RoboAG/eagle_keplerboard/bugfix/bugfix_isp_soldering.jpg

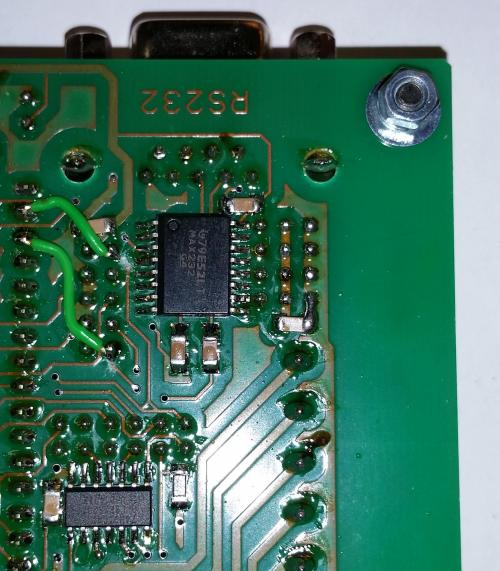
bugfix/bugfix_isp_soldering.jpg
