RoboAG/eagle_keplerboard/bugfix/bugfix_isp_scratching.jpg

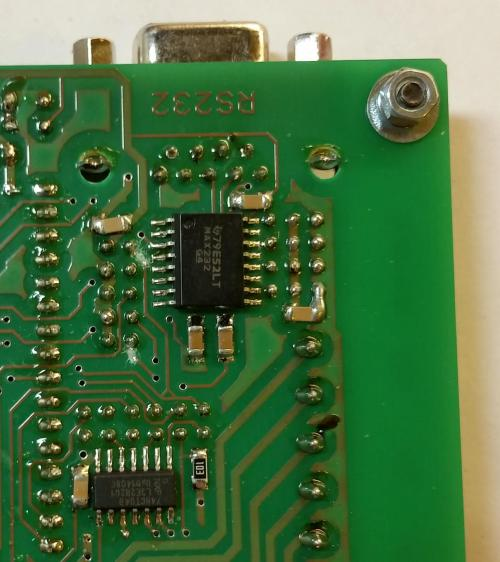
bugfix/bugfix_isp_scratching.jpg
