RoboAG/eagle_keplerboard/README.md

# keplerboard
Circuit for simple robots.
