RoboAG/eagle_keplerboard/bugfix/bugfix_isp_layout.png

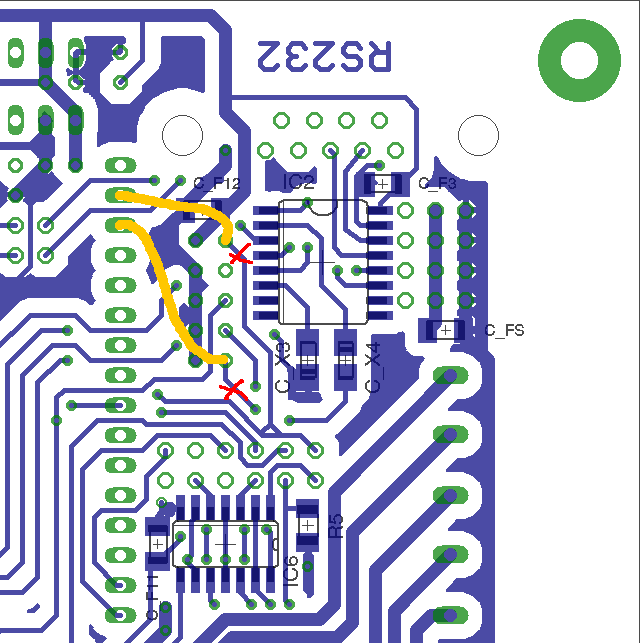
bugfix/bugfix_isp_layout.png
