RoboAG/eagle_keplerboard/bugfix/bugfix_label_porte.png

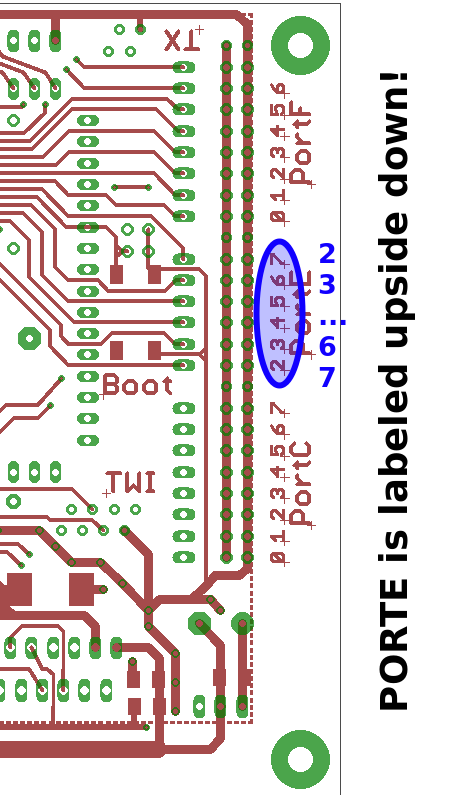
bugfix/bugfix_label_porte.png
