RoboAG/eagle_keplerboard/export/circuit.png

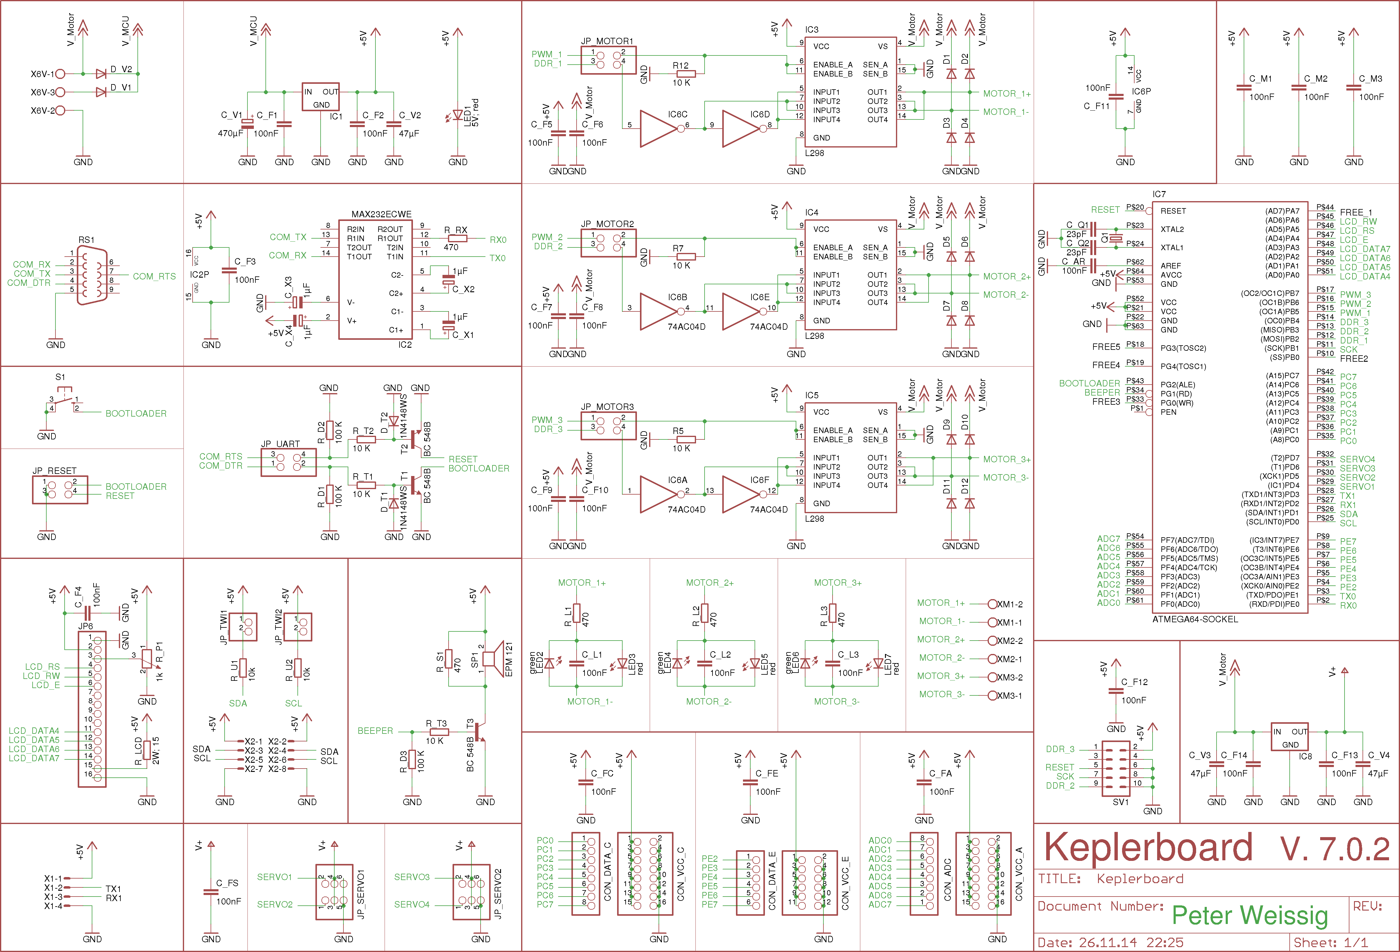
export/circuit.png
