RoboAG/eagle_keplerboard/export/layout_bottom.png

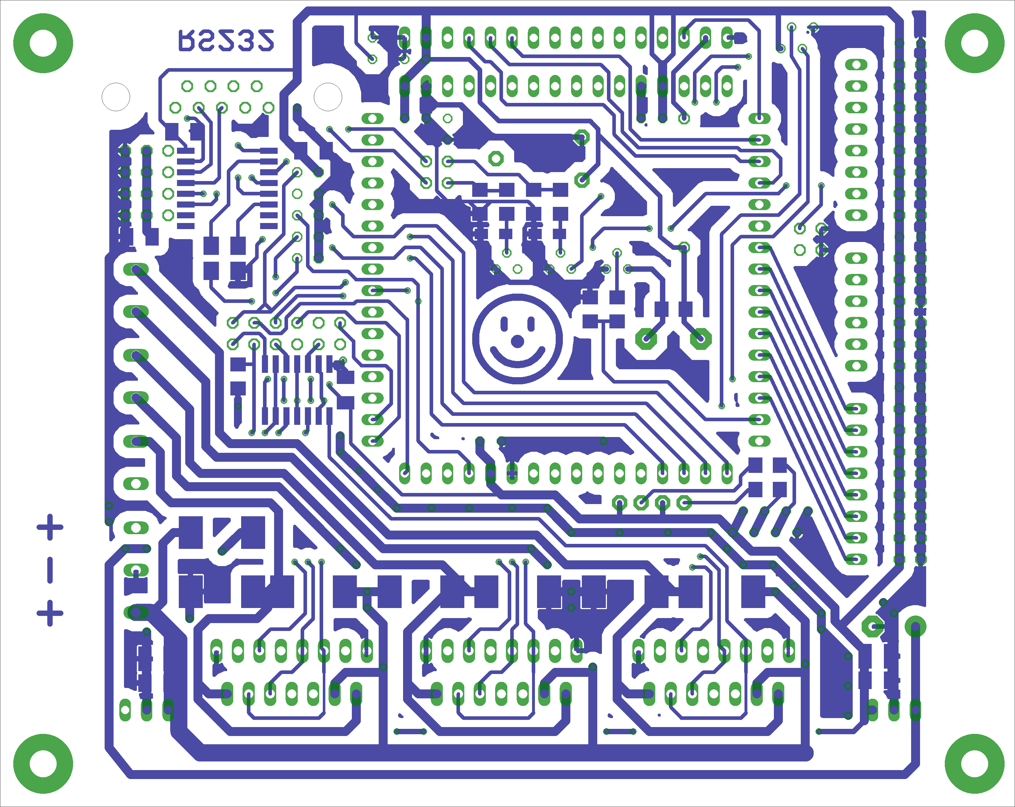
export/layout_bottom.png
