RoboAG/eagle_keplerboard/export/layout_top.png

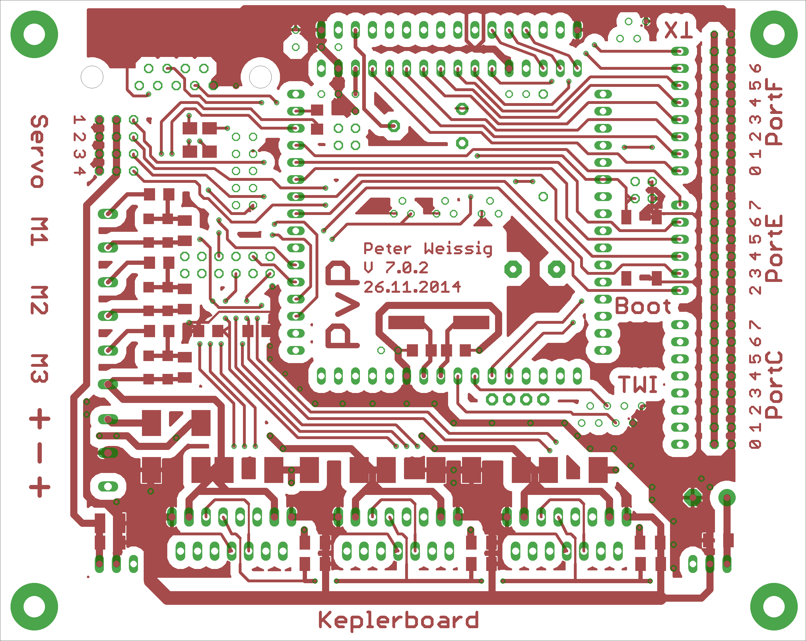
export/layout_top.png
