RoboAG/eagle_keplerboard/parts/parts.ods

Gruppe | Bauelement | Wert | Beschreibung | Bestellung (www.reichelt.de)
Widerstände | R_LCD | 15 | 2W; 12mm; d 4mm | 2W METALL 15 (http://www.reichelt.de/2W-METALL-15/3/index.html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) | 1 | 0,11 € | 0,11 €
 | R_L1 – R_L3 | 470 | SMD 1206; ¼ W | SMD 1/4W 470 (http://www.reichelt.de/SMD-1-4W-470/3/index.html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) | 5 | 0,10 € | 0,52 €
 | R_RX |  |  |  |  |  | 0,00 €
 | R_S1 |  |  |  |  |  | 0,00 €
 | R_P1 | 1k | Poti; liegend; linear | PT 10-L 1,0K (http://www.reichelt.de/PT-10-L-1-0K/3/index.html?ACTION=3&LA=446&ARTICLE=14617&artnr=PT+10-L+1,0K&SEARCH=PT+10-L+1,0K) | 1 | 0,23 € | 0,23 €
 | R5 | 10k | SMD 1206; ¼ W | SMD 1/4W 10K (http://www.reichelt.de/SMD-1-4W-10K/3/index.html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) | 8 | 0,10 € | 0,82 €
 | R7 |  |  |  |  |  | 0,00 €
 | R12 |  |  |  |  |  | 0,00 €
 | R_T1 – RT3 |  |  |  |  |  | 0,00 €
 | R_U1 – RU2 |  |  |  |  |  | 0,00 €
 | R_D1 – R_D3 | 100k | SMD 1206; ¼ W | SMD 1/4W 100K (http://www.reichelt.de/SMD-1-4W-100K/3/index.html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) | 3 | 0,10 € | 0,31 €
Quarz | Q1 | 16 Mhz | SMD; 13x4,7mm | 16,0000-HC49-SMD (http://www.reichelt.de/16-0000-HC49-SMD/3/index.html?ACTION=3&LA=446&ARTICLE=72515&artnr=16,0000-HC49-SMD&SEARCH=16,0000-HC49-SMD) | 1 | 0,19 € | 0,19 €
Kondensatoren | C_Q1 – C_Q2 | 23pF | SMD 1206 | NPO-G1206 22P (http://www.reichelt.de/NPO-G1206-22P/3/index.html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) | 2 | 0,05 € | 0,10 €
 | C_AR | 100nF | 2,54 mm; kerko; 50V | X7R-2,5 100N (http://www.reichelt.de/X7R-2-5-100N/3/index.html?ACTION=3&LA=446&ARTICLE=22853&artnr=X7R-2,5+100N&SEARCH=X7R-2,5+100N) | 8 | 0,04 € | 0,32 €
 | C_FA |  |  |  |  |  | 0,00 €
 | C_FC |  |  |  |  |  | 0,00 €
 | C_FE |  |  |  |  |  | 0,00 €
 | C_M1 – C_M3 |  |  |  |  |  | 0,00 €
 | C_F4 |  |  |  |  |  | 0,00 €
 | C_F1 – C_F3 | 100nF | SMD 1206; kerko; 63V | X7R-G1206 100N (http://www.reichelt.de/Vielschicht-SMD-G1206/X7R-G1206-100N/3/index.html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) | 17 | 0,05 € | 0,85 €
 | C_F5 – C_F14 |  |  |  |  |  | 0,00 €
 | C_FS |  |  |  |  |  | 0,00 €
 | C_L1 – C_L3 |  |  |  |  |  | 0,00 €
 | C_X1 – C_X4 | 1µF | SMD 1206; kerko; 50V | X7R-G1206 1,0/50 (http://www.reichelt.de/Vielschicht-SMD-G1206-High-Cap/X7R-G1206-1-0-50/3/index.html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,0/50) | 4 | 0,04 € | 0,16 €
 | C_V2 – C_V4 | 47µF | SMD 1210; kerko; 16V | X5R-G1210 47 (http://www.reichelt.de/Vielschicht-SMD-G1210-High-Cap/X5R-G1210-47/3/index.html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) | 3 | 0,45 € | 1,35 €
 | C_V1 | 470µF | 5mm; elko; 25V; d 10mm; h 12,5mm | RAD 470/25 (http://www.reichelt.de/Elkos-radial-85-C/RAD-470-25/3/index.html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) | 1 | 0,05 € | 0,05 €
Sum. | SP1 | EPM 121 | 7,6mm; piezo; d 14mm | SUMMER EPM 121 (http://www.reichelt.de/SUMMER-EPM-121/3/index.html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) | 1 | 0,67 € | 0,67 €
Leds | LED1 | red | 3mm; 5V (mit Vorwiderstand) | LED 3MM 5V RT (http://www.reichelt.de/LED-3MM-5V-RT/3/index.html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) | 1 | 0,18 € | 0,18 €
 | LED2 | green | SMD 1206; grün; 2,2V; 25mA | SMD-LED 1206 GN (http://www.reichelt.de/SMD-LED-1206-GN/3/index.html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) | 3 | 0,10 € | 0,30 €
 | LED4 |  |  |  |  |  | 0,00 €
 | LED6 |  |  |  |  |  | 0,00 €
 | LED3 | red | SMD 1206; rot; 2,0V; 30mA | SMD-LED 1206 RT (http://www.reichelt.de/SMD-LED-1206-RT/3/index.html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) | 3 | 0,11 € | 0,33 €
 | LED5 |  |  |  |  |  | 0,00 €
 | LED7 |  |  |  |  |  | 0,00 €
Dioden | D_T1 – D_T2 | 150mA | SMD 1,8x1,4mm; 72V; 0,15A | 1N4148 WS (http://www.reichelt.de/1N-4148-WS/3/index.html?ACTION=3&LA=446&ARTICLE=95197&artnr=1N+4148+WS&SEARCH=1N4148+WS) | 2 | 0,03 € | 0,06 €
 | D1 – D12 | 3A | SMD 6x7mm; Schottky; 60V; 3A | MBRS 360 SMD (http://www.reichelt.de/MBRS-360-SMD/3/index.html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) | 14 | 0,19 € | 2,66 €
 | D_V1 – D_V2 |  |  |  |  |  | 0,00 €
Trans. | T1 – T3 | BC 548B | NPN; 30V; 100mA | BC 548B (http://www.reichelt.de/BC-548B/3/index.html?ACTION=3&LA=446&ARTICLE=5009&artnr=BC+548B&SEARCH=BC+548B) | 3 | 0,04 € | 0,12 €
Schaltkreise | IC1 | 5V | Spg-Reg.; 5V; 1A; Kühlkörper | LM294 CT5 (http://www.reichelt.de/LM-2940-CT5/3/index.html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) | 2 | 0,51 € | 1,02 €
 | IC8 |  |  |  |  |  | 0,00 €
 | IC2 | MAX232 | SMD; Pegelwandler; 5V<->8V | MAX 232 CWE (http://www.reichelt.de/MAX-232-CWE/3/index.html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) | 1 | 0,70 € | 0,70 €
 | IC3 – IC5 | L298 | Motortreiber; 2x2A; 25W | L298 (http://www.reichelt.de/L-298/3/index.html?&ACTION=3&LA=446&ARTICLE=9667&artnr=L+298&SEARCH=L298) | 3 | 2,15 € | 6,45 €
 | IC6 | 74HC04D | SMD; Logikgatter; 6x Inverter | SMD HC 04 (http://www.reichelt.de/SMD-HC-04/3/index.html?ACTION=3&LA=446&ARTICLE=18627&artnr=SMD+HC+04&SEARCH=SMD+HC+04) | 1 | 0,14 € | 0,14 €
 | IC7 | Mega2561 | SMD; RAM 8k; Flash 256k | ATMEGA 2561-16AU (http://www.reichelt.de/ATMEGA-2561-16AU/3/index.html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) | 1 | 8,80 € | 8,80 €
 |  | Stiftl. | 4x 16 pins; 2,54mm; h 8mm | SL 1X36G 2,54 (http://www.reichelt.de/SL-1X36G-2-54/3/index.html?ACTION=3&LA=446&ARTICLE=19504&artnr=SL+1X36G+2,54&SEARCH=SL+1X36G+2,54) | 2 | 0,15 € | 0,30 €
 |  | Kond. | 1µF; SMD 1206; kerko; 50V | X7R-G1206 1,0/50 (http://www.reichelt.de/Vielschicht-SMD-G1206-High-Cap/X7R-G1206-1-0-50/3/index.html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,0/50) | 3 | 0,04 € | 0,12 €
 |  | Platine | Atmega-Adapter-Platine |  | 1 |  | 0,00 €
Taster | S1 | Kurzhub | SMD; h 5mm | TASTER 9315 (http://www.reichelt.de/Kurzhubtaster/TASTER-9315/3/index.html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) | 1 | 0,20 € | 0,20 €
Buchsenleisten | CON_ADC | 1x8 | 8 pins; 2,54mm; h 8mm | BL 1X20G8 2,54 (http://www.reichelt.de/BL-1X20G8-2-54/3/index.html?ACTION=3&LA=446&ARTICLE=51827&artnr=BL+1X20G8+2,54&SEARCH=BL+1X20G8+2,54) | 7 | 0,31 € | 2,17 €
 | CON_DATA_C |  |  |  |  |  | 0,00 €
 | CON_DATA_E | 1x6 | 6 pins; 2,54mm; h 8mm |  |  |  | 0,00 €
 | IC7 – Atmega | 4x 1x16 | 4x 16 pins; 2,54mm; h 8mm |  |  |  | 0,00 €
 | JP16 | 1x16 | 16 pins; 2,54mm; h 8mm |  |  |  | 0,00 €
 | CON_VCC_A | 2x8 | 2x8 pins; 2,54mm; h 8mm | BL 2X10G8 2,54 (http://www.reichelt.de/BL-2X10G8-2-54/3/index.html?ACTION=3&LA=446&ARTICLE=51833&artnr=BL+2X10G8+2,54&SEARCH=BL+2X+10G8+2,54) | 3 | 0,29 € | 0,87 €
 | CON_VCC_C |  |  |  |  |  | 0,00 €
 | CON_VCC_E |  |  |  |  |  | 0,00 €
Stiftleiste | JP_TWI1 | 1x2 | Zusammen: 1x4 pins; 2,54mm; h 8mm | SL 1X36G 2,54 (http://www.reichelt.de/SL-1X36G-2-54/3/index.html?ACTION=3&LA=446&ARTICLE=19504&artnr=SL+1X36G+2,54&SEARCH=SL+1X36G+2,54) | 1 | 0,15 € | 0,15 €
 | JP_TWI2 |  |  |  |  |  | 0,00 €
 | JP_MOTOR1 | 2x2 | Zusammen: 2x6 pins; 2,54mm; h 8mm | SL 2X36G 2,54 (http://www.reichelt.de/SL-2X36G-2-54/3/index.html?ACTION=3&LA=446&ARTICLE=19496&artnr=SL+2X36G+2,54&SEARCH=SL+2X36G+2,54) | 1 | 0,32 € | 0,32 €
 | JP_MOTOR2 |  |  |  |  |  | 0,00 €
 | JP_MOTOR3 |  |  |  |  |  | 0,00 €
 | JP_RESET | 2x2 | 2x2 pins; 2,54mm; h 8mm |  |  |  | 0,00 €
 | JP_SERVO1 | 2x3 | 2x3 pins; 2,54mm; h 8mm |  |  |  | 0,00 €
 | JP_SERVO2 |  |  |  |  |  | 0,00 €
 | JP_UART | 2x2 | 2x2 pins; 2,54mm; h 8mm |  |  |  | 0,00 €
Anschlüße | SV1 | 2x5 | 2x5 pins; Wannenstecker | WSL 10G (http://www.reichelt.de/WSL-10G/3/index.html?ACTION=3&LA=446&ARTICLE=22816&artnr=WSL+10G&SEARCH=WSL+10G) | 1 | 0,08 € | 0,08 €
 | X1 | 2x2 | micromatch 4polig | MM FL 4G (http://www.reichelt.de/Micro-Match-Verbinder/MM-FL-4G/3/index.html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) | 1 | 0,25 € | 0,25 €
 | X2 | 2x4 | micromatch 8polig | MM FL 8G (http://www.reichelt.de/Micro-Match-Verbinder/MM-FL-8G/3/index.html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) | 1 | 0,41 € | 0,41 €
 | X6V | 1x3 | 5,08mm; Schraubanschluss | AKL101-03 (http://www.reichelt.de/index.html?ACTION=3;ARTICLE=36606;SEARCH=AKL%20101-03) | 1 | 0,31 € | 0,31 €
 | XM1 – XM3 | 1x2 | 5,08mm; Schraubanschluss | AKL101-02 (http://www.reichelt.de/RIA-Stecksystem/AKL-101-02/3/index.html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) | 3 | 0,31 € | 0,93 €
 | RS1 | dsub9 | Buchse | D-SUB BU 09EU (http://www.reichelt.de/D-SUB-BU-09EU/3/index.html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) | 1 | 0,39 € | 0,39 €
Extras | Stecker für UART (Xbee) |  | Stecker für micromatch 4polig | MM SL 4SK (http://www.reichelt.de/Micro-Match-Verbinder/MM-SL-4SK/3/index.html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) |  | 0,23 € | 0,00 €
 | Stecker für TWI |  | Stecker für micromatch 8polig | MM SL 8SK (http://www.reichelt.de/Micro-Match-Verbinder/MPE-371-1-008/3/index.html?ACTION=3;ARTICLE=52838;SEARCH=MM%20SL%208SK) |  | 0,28 € | 0,00 €
 | Anschluss von Sensoren und Display |  | 16er-Kabel; grau; 3m | AWG 28-16G 3M (http://www.reichelt.de/Flachbandkabel/AWG-28-16G-3M/3/index.html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) |  | 1,75 € | 0,00 €
 |  |  | 16er-Kabel; bunt; 3m | AWG 28-16F 3M (http://www.reichelt.de/Flachbandkabel/AWG-28-16F-3M/3/index.html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) |  | 3,00 € | 0,00 €
 |  |  | Stiftleisten | SL 1X36G 2,54 (http://www.reichelt.de/SL-1X36G-2-54/3/index.html?ACTION=3&LA=446&ARTICLE=19504&artnr=SL+1X36G+2,54&SEARCH=SL+1X36G+2,54) |  | 0,15 € | 0,00 €
 |  |  | Schrumpfschlauch; Schwarz | SDH 1,6 SW (http://www.reichelt.de/Schrumpfschlauch-Abschnitte/SDH-1-6-SW/3/index.html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,6+SW) |  | 0,25 € | 0,00 €
 |  |  | Schrumpfschlauch; Rot | SDH 1,6 RT (http://www.reichelt.de/Schrumpfschlauch-Abschnitte/SDH-1-6-RT/3/index.html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,6+RT) |  | 0,32 € | 0,00 €
 |  |  | Schrumpfschlauch; Blau | SDH 1,6 BL (http://www.reichelt.de/Schrumpfschlauch-Abschnitte/SDH-1-6-BL/3/index.html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,6+BL) |  | 0,32 € | 0,00 €
 | Versand |  |  |  | 1 | 5,60 € | 5,60 €
 |  |  |  | Summe | 38,54 €
