RoboAG/eagle_keplerboard/export/parts_bottom.png

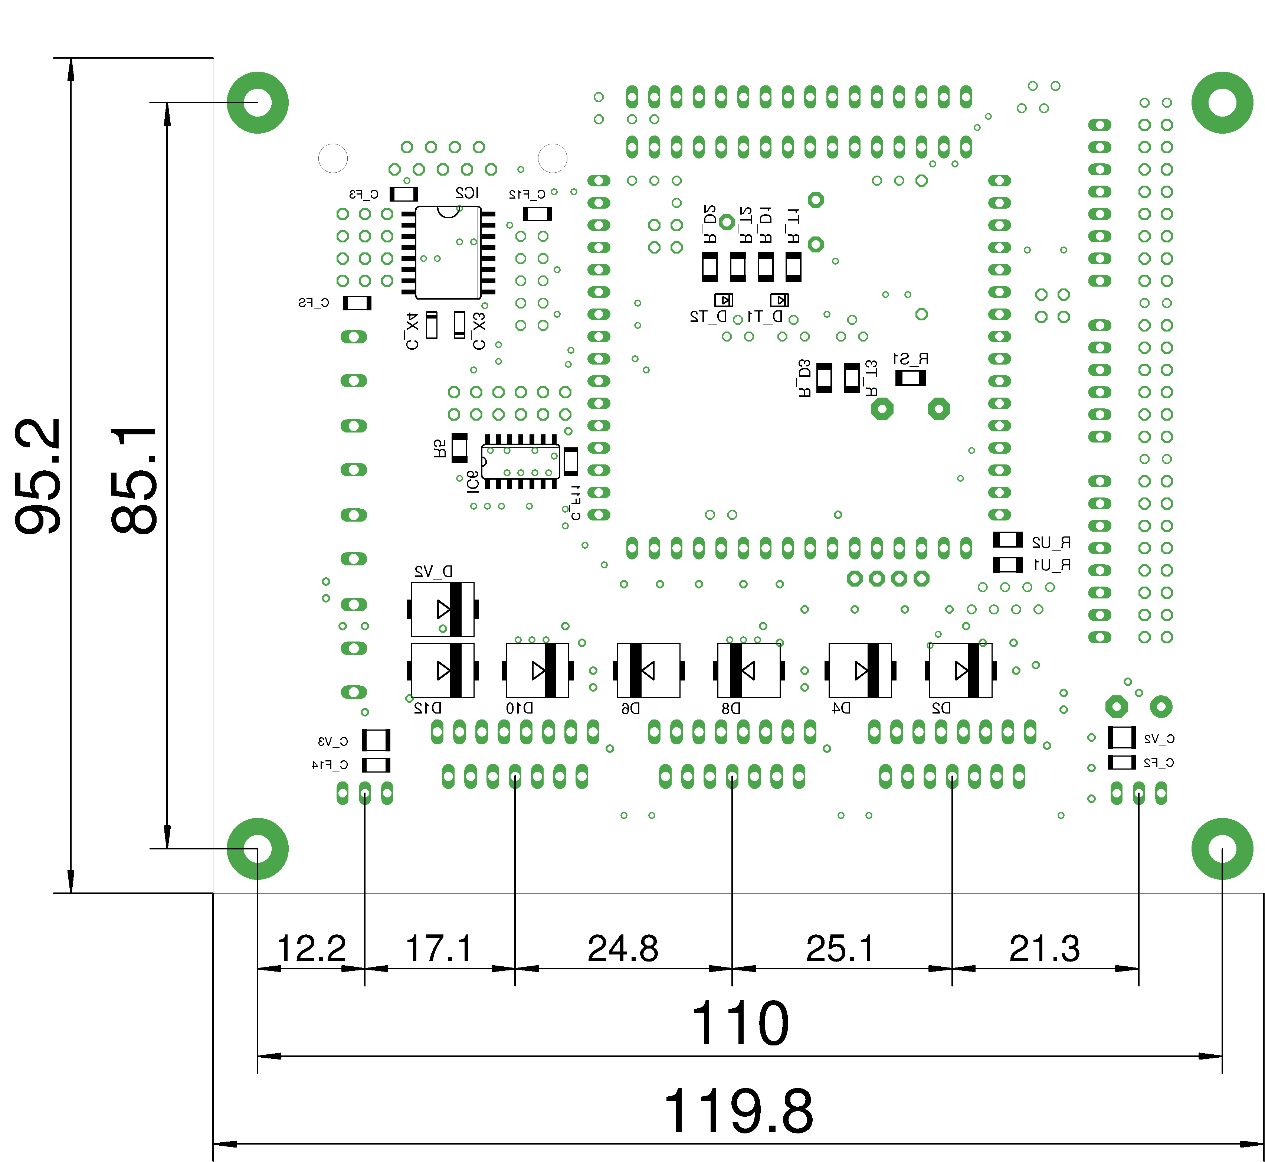
export/parts_bottom.png
