RoboAG/eagle_keplerboard/export/parts_top.png

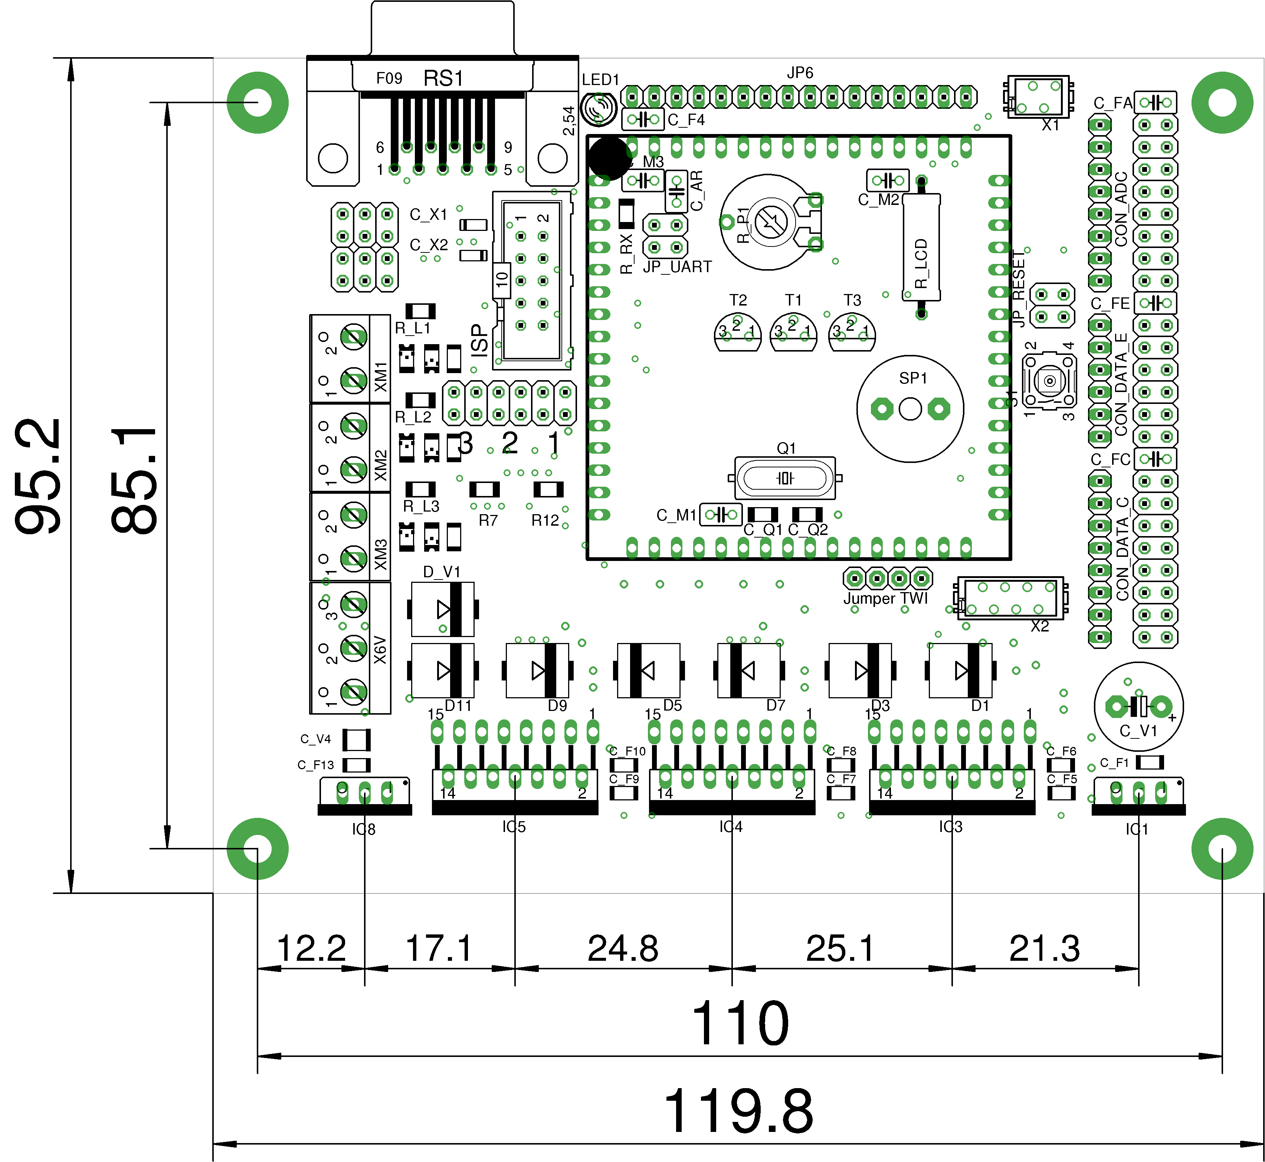
export/parts_top.png
