RoboAG/eagle_keplerboard/parts/parts.pdf

# Bauteile Keplerboard V7.0.2

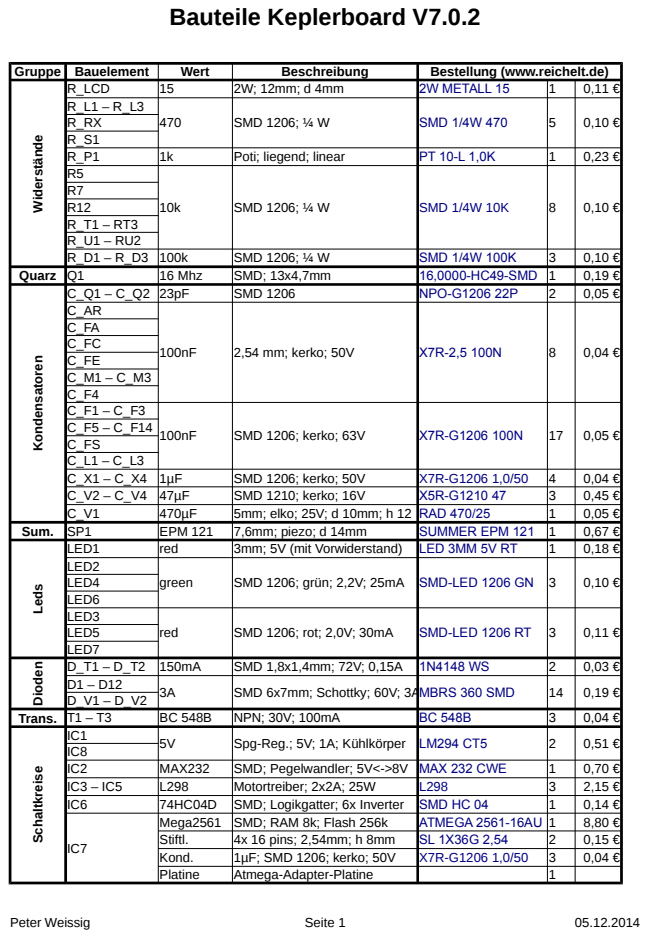
[picture p10: page 1]

# Bauteile Keplerboard V7.0.2

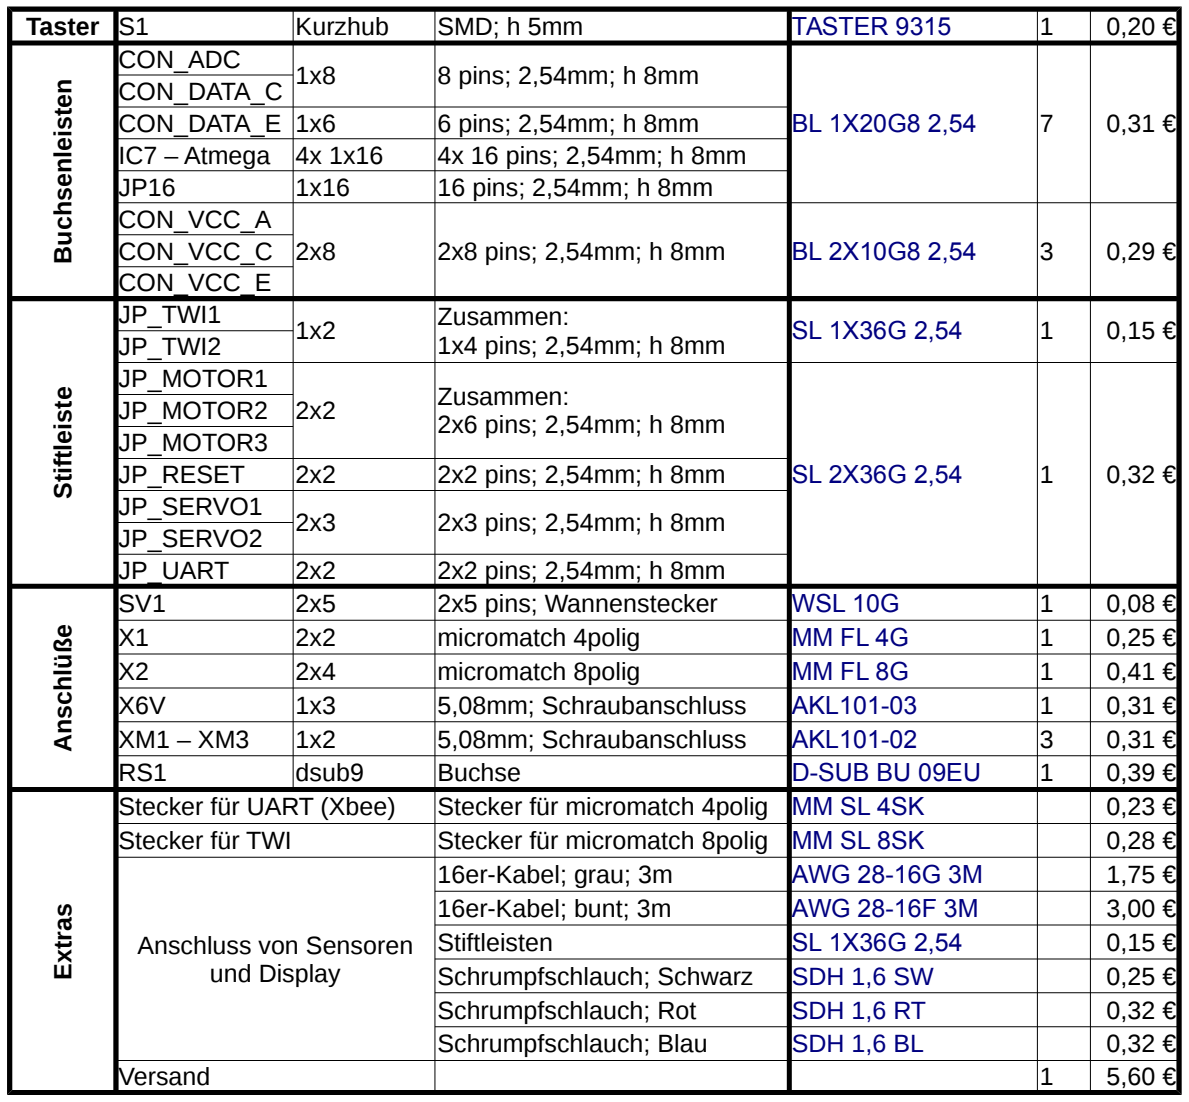
[picture p11: figure]
Taster S1; Kurzhub; SMD; h 5mm; nleiste; CON_ADC; 8 pins; 2,54mm; h 8mm; CON_DATA_C; CON_DATA_E; 6 pins; 2,54mm; h 8mm; 16 pins; 2,54mm; h 8mm; CON_VCC_A; CON_VCC_C; 2x8 pins; 2,54mm; h 8mm; CON_VCC_E; Stiftleiste; JP_TWI1; 0,15 € JP_TWI2; JP_MOTOR1; JP_MOTOR2 JP_MOTOR3; JP_RESET; 2x2 pins; 2,54mm; h 8mm; JP_UART; hlü; 2x5 pins; Wannenstecker; micromatch 4polig; micromatch 8polig; 5,08mm; Schraubanschluss; dsub9; Buchse; xtra; Stecker für UART (Xbee); Stecker für micromatch 4polig; Stecker für TWI; Stecker für micromatch 8polig; 16er-Kabel; grau; 3m; 16er-Kabel; bunt; 3m; Stiftleisten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

Peter Weissig | Seite 2 | 05.12.2014
IC7 – Atmega | 4x 1x16 | 4x 16 pins; 2,54mm; h 8mm
JP_SERVO1 | 2x3 | 2x3 pins; 2,54mm; h 8mm JP_SERVO2
Summe | 38,54 €
