RoboAG/eagle_keplerboard/export/circuit.pdf

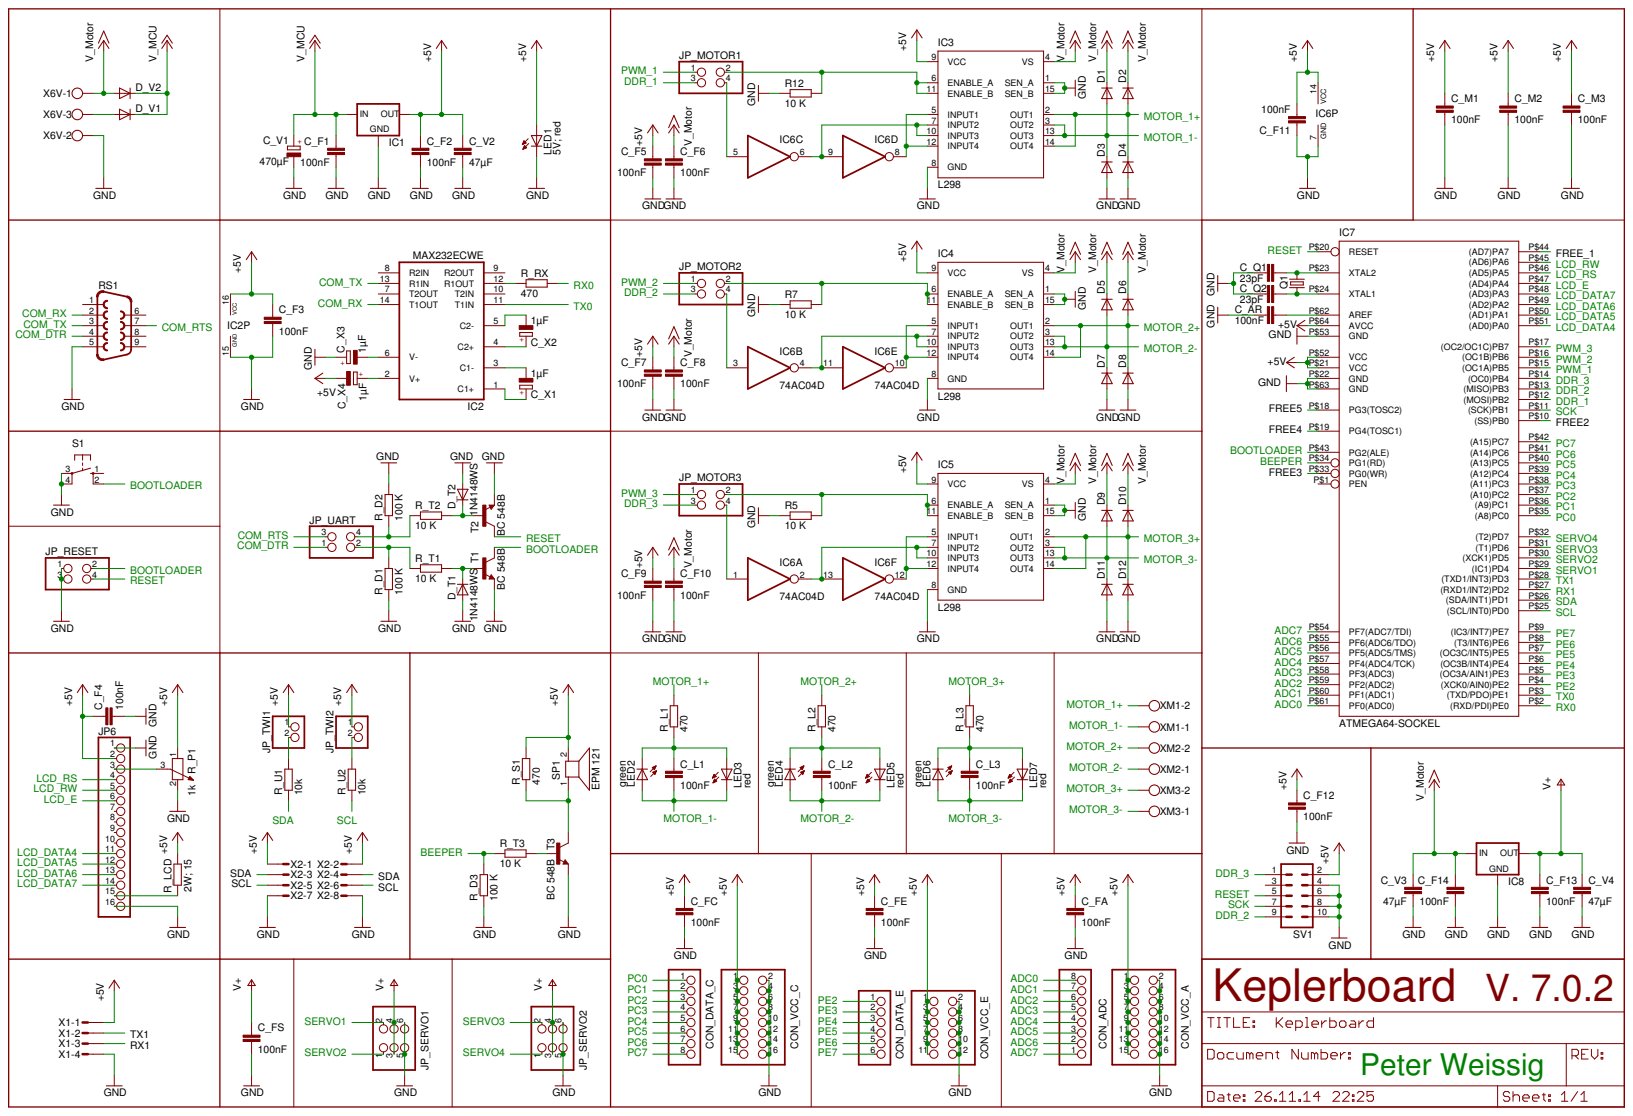
[picture p12: page 1]

V_MCU GND GND GND GND GND

GNDGND
