RoboAG/eagle_keplerboard/circuit/circuit.brd

## EAGLE design circuit/circuit.brd (2015-09-28)

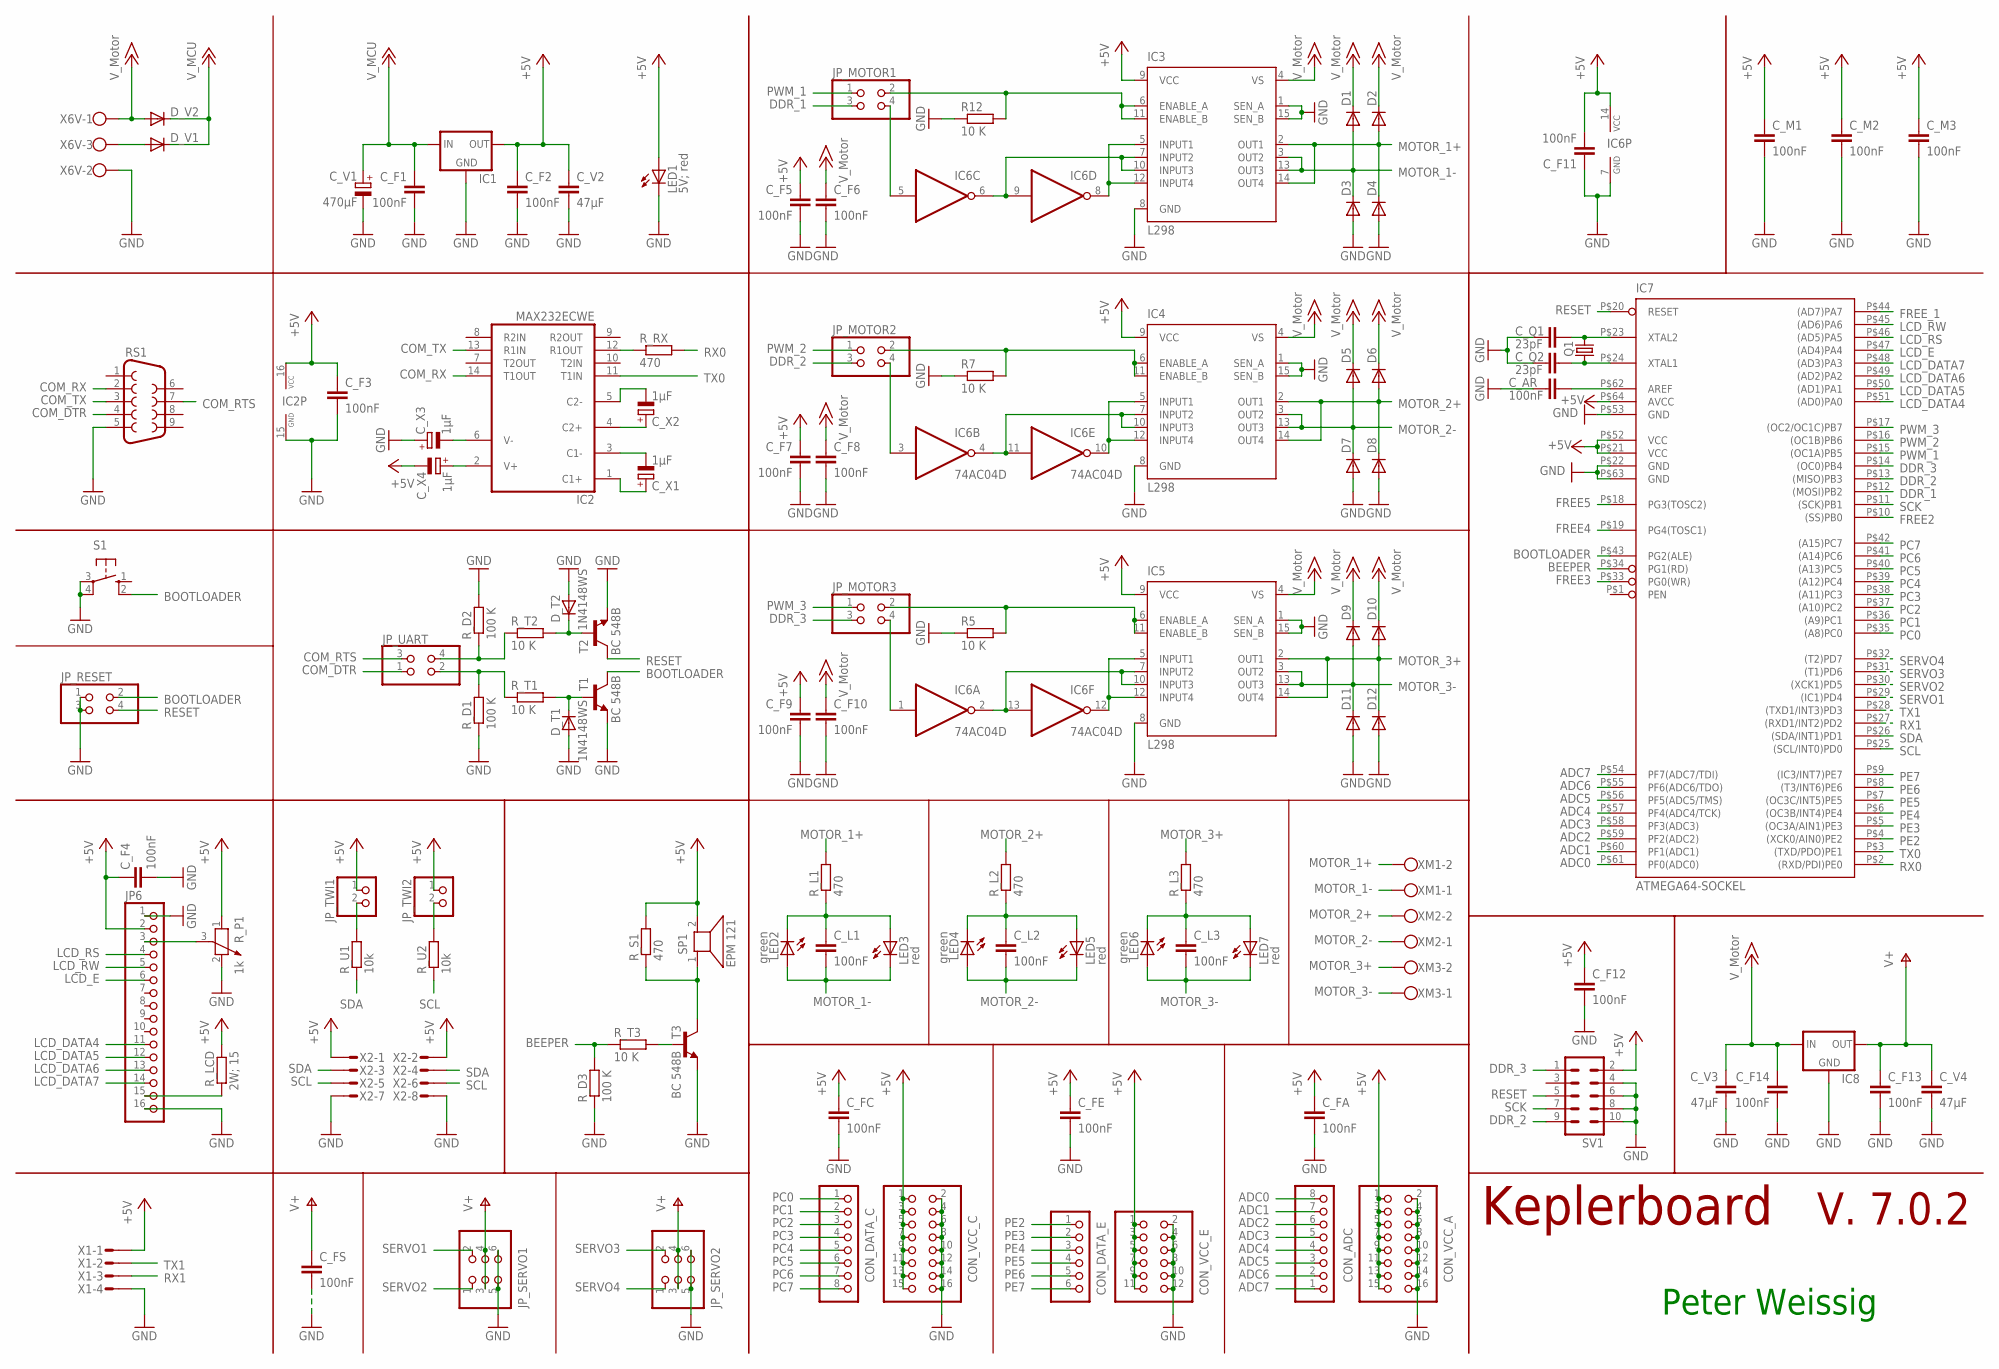
[picture p13: schematic circuit.sch]

Parts:
CON_ADC: PINHD-1X8; 1X08
CON_DATA_C: PINHD-1X8; 1X08
CON_DATA_E: PINHD-1X6; 1X06
CON_VCC_A: PINHD-2X8; 2X08
CON_VCC_C: PINHD-2X8; 2X08
CON_VCC_E: PINHD-2X6; 2X06
C_AR: 100nF; C025-025X050
C_F1, C_F2, C_F3, C_F5, C_F6, C_F7, C_F8, C_F9, C_F10, C_F11, C_F12, C_F13, C_F14: 100nF; C1206K
C_F4: 100nF; C025-025X050
C_FA: 100nF; C025-025X050
C_FC: 100nF; C025-025X050
C_FE: 100nF; C025-025X050
C_FS: 100nF; C1206K
C_L1, C_L2, C_L3: 100nF; C1206K
C_M1, C_M2, C_M3: 100nF; C025-025X050
C_Q1, C_Q2: 23pF; C3216
C_V1: 470µF; E5-10,5
C_V2, C_V3, C_V4: 47µF; C1210K
C_X1, C_X2, C_X3, C_X4: 1µF; A/3216-18W
D1, D2, D3, D4, D5, D6, D7, D8, D9, D10, D11, D12: DIODE-SMC; SMC
D_T1, D_T2: 1N4148WS; SOD323-W
D_V1, D_V2: DIODE-SMC; SMC
IC1, IC8: 78XXS
IC2: MAX232ECWE; SO16L
IC3, IC4, IC5: L298; MULTIWATT-15
IC6: 74AC04D; SO14
IC7: ATMEGA64-SOCKEL; SOCKEL_TQFP64
JP6: PINHD-1X16; 1X16
JP_MOTOR1, JP_MOTOR2, JP_MOTOR3: PINHD-2X2; 2X02
JP_RESET: PINHD-2X2; 2X02
JP_SERVO1, JP_SERVO2: PINHD-2X3; 2X03
JP_TWI1, JP_TWI2: PINHD-1X2; 1X02
JP_UART: PINHD-2X2; 2X02
LED1: 5V; red; LED3MM
LED2, LED4, LED6: green; CHIPLED_1206
LED3, LED5, LED7: red; CHIPLED_1206
Q1: CRYSTALHC49UP; HC49UP
R5, R7, R12: 10 K; R1206
RS1: F09H
R_D1, R_D2, R_D3: 100 K; R1206
R_L1, R_L2, R_L3: 470; R1206
R_LCD: 2W; 15; 0414/15
R_P1: 1k; PT-10
R_RX: 470; R1206
R_S1: 470; R1206
R_T1, R_T2, R_T3: 10 K; R1206
R_U1, R_U2: 10k; R1206
S1: TASTER; TASTER_SMD
SP1: EPM 121; AL60P
SV1: ML10
T1, T2, T3: BC 548B; TO92
X1: MICROMATCH-4
X2: MICROMATCH-8
X6V: W237-103
XM1, XM2, XM3: W237-102

Connections:
+5V: CON_VCC_A.1, CON_VCC_A.3, CON_VCC_A.5, CON_VCC_A.7, CON_VCC_A.9, CON_VCC_A.11, CON_VCC_A.13, CON_VCC_A.15, CON_VCC_C.1, CON_VCC_C.3, CON_VCC_C.5, CON_VCC_C.7, CON_VCC_C.9, CON_VCC_C.11, CON_VCC_C.13, CON_VCC_C.15, CON_VCC_E.1, CON_VCC_E.3, CON_VCC_E.5, CON_VCC_E.7, CON_VCC_E.9, CON_VCC_E.11, C_F2.1, C_F3.1, C_F4.1, C_F5.1, C_F7.1, C_F9.1, C_F11.2, C_F12.1, C_FA.1, C_FC.1, C_FE.1, C_M1.1, C_M2.1, C_M3.1, C_V2.1, C_X4.-, IC1.OUT, IC2.16 (VCC), IC3.9 (VCC), IC4.9 (VCC), IC5.9 (VCC), IC6.14 (VCC), IC7.P$21 (VCC), IC7.P$52 (VCC), IC7.P$64 (AVCC), JP6.2, JP_TWI1.1, JP_TWI2.1, LED1.A, R_LCD.1, R_P1.1, R_S1.2, SP1.2, SV1.2, X1.1, X2.1, X2.2
+12V: C_F1.1, C_V1.+, D_V1.C, D_V2.C, IC1.IN
+15V: C_F6.1, C_F8.1, C_F10.1, C_F14.1, C_V3.1, D1.C, D2.C, D5.C, D6.C, D9.C, D10.C, D_V2.A, IC3.4 (VS), IC4.4 (VS), IC5.4 (VS), IC8.IN, X6V.1
ADC0: CON_ADC.8, IC7.P$61 (PF0(ADC0))
ADC1: CON_ADC.7, IC7.P$60 (PF1(ADC1))
ADC2: CON_ADC.6, IC7.P$59 (PF2(ADC2))
ADC3: CON_ADC.5, IC7.P$58 (PF3(ADC3))
ADC4: CON_ADC.4, IC7.P$57 (PF4(ADC4/TCK))
ADC5: CON_ADC.3, IC7.P$56 (PF5(ADC5/TMS))
ADC6: CON_ADC.2, IC7.P$55 (PF6(ADC6/TDO))
ADC7: CON_ADC.1, IC7.P$54 (PF7(ADC7/TDI))
BEEPER: IC7.P$34 (PG1(RD)), R_D3.2, R_T3.1
BOOTLOADER: IC7.P$43 (PG2(ALE)), JP_RESET.2, S1.2 (S1), T1.1 (C)
COM_DTR: JP_UART.1, RS1.4
COM_RTS: JP_UART.3, RS1.7
COM_RX: IC2.14 (T1OUT), RS1.2
COM_TX: IC2.13 (R1IN), RS1.3
DDR_1: IC7.P$12 ((MOSI)PB2), JP_MOTOR1.3
DDR_2: IC7.P$13 ((MISO)PB3), JP_MOTOR2.3, SV1.9
DDR_3: IC7.P$14 ((OC0)PB4), JP_MOTOR3.3, SV1.1
FREE2: IC7.P$10 ((SS)PB0)
FREE3: IC7.P$33 (PG0(WR))
FREE4: IC7.P$19 (PG4(TOSC1))
FREE5: IC7.P$18 (PG3(TOSC2))
FREE_1: IC7.P$44 ((AD7)PA7)
GND: CON_VCC_A.2, CON_VCC_A.4, CON_VCC_A.6, CON_VCC_A.8, CON_VCC_A.10, CON_VCC_A.12, CON_VCC_A.14, CON_VCC_A.16, CON_VCC_C.2, CON_VCC_C.4, CON_VCC_C.6, CON_VCC_C.8, CON_VCC_C.10, CON_VCC_C.12, CON_VCC_C.14, CON_VCC_C.16, CON_VCC_E.2, CON_VCC_E.4, CON_VCC_E.6, CON_VCC_E.8, CON_VCC_E.10, CON_VCC_E.12, C_AR.1, C_F1.2, C_F2.2, C_F3.2, C_F4.2, C_F5.2, C_F6.2, C_F7.2, C_F8.2, C_F9.2, C_F10.2, C_F11.1, C_F12.2, C_F13.2, C_F14.2, C_FA.2, C_FC.2, C_FE.2, C_FS.2, C_M1.2, C_M2.2, C_M3.2, C_Q1.1, C_Q2.1, C_V1.-, C_V2.2, C_V3.2, C_V4.2, C_X3.+, D3.A, D4.A, D7.A, D8.A, D11.A, D12.A, D_T1.A, D_T2.A, IC1.GND, IC2.15 (GND), IC3.1 (SEN_A), IC3.8 (GND), IC3.15 (SEN_B), IC4.1 (SEN_A), IC4.8 (GND), IC4.15 (SEN_B), IC5.1 (SEN_A), IC5.8 (GND), IC5.15 (SEN_B), IC6.7 (GND), IC7.P$22 (GND), IC7.P$53 (GND), IC7.P$63 (GND), IC8.GND, JP6.1, JP6.16, JP_RESET.1, JP_RESET.3, JP_SERVO1.5, JP_SERVO1.6, JP_SERVO2.5, JP_SERVO2.6, LED1.K (C), R5.1, R7.1, R12.1, RS1.5, R_D1.1, R_D2.2, R_D3.1, R_P1.2, S1.3, S1.4 (P1), SV1.4, SV1.6, SV1.8, SV1.10, T1.3 (E), T2.3 (E), T3.3 (E), X1.4, X2.7, X2.8, X6V.2
LCD_DATA4: IC7.P$51 ((AD0)PA0), JP6.11
LCD_DATA5: IC7.P$50 ((AD1)PA1), JP6.12
LCD_DATA6: IC7.P$49 ((AD2)PA2), JP6.13
LCD_DATA7: IC7.P$48 ((AD3)PA3), JP6.14
LCD_E: IC7.P$47 ((AD4)PA4), JP6.6
LCD_RS: IC7.P$46 ((AD5)PA5), JP6.4
LCD_RW: IC7.P$45 ((AD6)PA6), JP6.5
MOTOR_1+: D2.A, D4.C, IC3.2 (OUT1), IC3.14 (OUT4), R_L1.2, XM1.2
MOTOR_1-: C_L1.2, D1.A, D3.C, IC3.3 (OUT2), IC3.13 (OUT3), LED2.A, LED3.C, XM1.1
MOTOR_2+: D6.A, D8.C, IC4.2 (OUT1), IC4.14 (OUT4), R_L2.2, XM2.2
MOTOR_2-: C_L2.2, D5.A, D7.C, IC4.3 (OUT2), IC4.13 (OUT3), LED4.A, LED5.C, XM2.1
MOTOR_3+: D10.A, D12.C, IC5.2 (OUT1), IC5.14 (OUT4), R_L3.2, XM3.2
MOTOR_3-: C_L3.2, D9.A, D11.C, IC5.3 (OUT2), IC5.13 (OUT3), LED6.A, LED7.C, XM3.1
unnamed: IC6.3 (I), JP_MOTOR2.4
unnamed: IC4.7 (INPUT2), IC4.10 (INPUT3), IC6.4 (O), IC6.11 (I)
unnamed: JP_TWI1.2, R_U1.2
unnamed: R_S1.1, SP1.1, T3.1 (C)
unnamed: R_T3.2, T3.2 (B)
unnamed: JP6.3, R_P1.3
unnamed: C_AR.2, IC7.P$62 (AREF)
unnamed: IC4.6 (ENABLE_A), IC4.11 (ENABLE_B), JP_MOTOR2.2, R7.2
unnamed: JP_TWI2.2, R_U2.2
unnamed: D_V1.A, X6V.3
unnamed: IC4.5 (INPUT1), IC4.12 (INPUT4), IC6.10 (O)
unnamed: C_Q1.2, IC7.P$23 (XTAL2), Q1.2
unnamed: C_L1.1, LED2.C, LED3.A, R_L1.1
unnamed: C_Q2.2, IC7.P$24 (XTAL1), Q1.1
unnamed: IC5.5 (INPUT1), IC5.12 (INPUT4), IC6.12 (O)
unnamed: IC6.5 (I), JP_MOTOR1.4
unnamed: IC3.5 (INPUT1), IC3.12 (INPUT4), IC6.8 (O)
unnamed: IC3.7 (INPUT2), IC3.10 (INPUT3), IC6.6 (O), IC6.9 (I)
unnamed: IC6.1 (I), JP_MOTOR3.4
unnamed: JP6.15, R_LCD.2
unnamed: D_T2.C, R_T2.2, T2.2 (B)
unnamed: IC5.7 (INPUT2), IC5.10 (INPUT3), IC6.2 (O), IC6.13 (I)
unnamed: C_L3.1, LED6.C, LED7.A, R_L3.1
unnamed: C_L2.1, LED4.C, LED5.A, R_L2.1
unnamed: D_T1.C, R_T1.2, T1.2 (B)
unnamed: C_X4.+, IC2.2 (V+)
unnamed: C_X3.-, IC2.6 (V-)
unnamed: C_X2.+, IC2.4 (C2+)
unnamed: C_X1.+, IC2.1 (C1+)
unnamed: C_X1.-, IC2.3 (C1-)
unnamed: C_X2.-, IC2.5 (C2-)
unnamed: JP_UART.2, R_D1.2, R_T1.1
unnamed: JP_UART.4, R_D2.1, R_T2.1
unnamed: IC2.12 (R1OUT), R_RX.1
PC0: CON_DATA_C.1, IC7.P$35 ((A8)PC0)
PC1: CON_DATA_C.2, IC7.P$36 ((A9)PC1)
PC2: CON_DATA_C.3, IC7.P$37 ((A10)PC2)
PC3: CON_DATA_C.4, IC7.P$38 ((A11)PC3)
PC4: CON_DATA_C.5, IC7.P$39 ((A12)PC4)
PC5: CON_DATA_C.6, IC7.P$40 ((A13)PC5)
PC6: CON_DATA_C.7, IC7.P$41 ((A14)PC6)
PC7: CON_DATA_C.8, IC7.P$42 ((A15)PC7)
PE2: CON_DATA_E.1, IC7.P$4 ((XCK0/AIN0)PE2)
PE3: CON_DATA_E.2, IC7.P$5 ((OC3A/AIN1)PE3)
PE4: CON_DATA_E.3, IC7.P$6 ((OC3B/INT4)PE4)
PE5: CON_DATA_E.4, IC7.P$7 ((OC3C/INT5)PE5)
PE6: CON_DATA_E.5, IC7.P$8 ((T3/INT6)PE6)
PE7: CON_DATA_E.6, IC7.P$9 ((IC3/INT7)PE7)
PWMM1: IC3.6 (ENABLE_A), IC3.11 (ENABLE_B), JP_MOTOR1.2, R12.2
PWMM3: IC5.6 (ENABLE_A), IC5.11 (ENABLE_B), JP_MOTOR3.2, R5.2
PWM_1: IC7.P$15 ((OC1A)PB5), JP_MOTOR1.1
PWM_2: IC7.P$16 ((OC1B)PB6), JP_MOTOR2.1
PWM_3: IC7.P$17 ((OC2/OC1C)PB7), JP_MOTOR3.1
RESET: IC7.P$20 (RESET), JP_RESET.4, SV1.5, T2.1 (C)
RX0: IC7.P$2 ((RXD/PDI)PE0), R_RX.2
RX1: IC7.P$27 ((RXD1/INT2)PD2), X1.3
SCK: IC7.P$11 ((SCK)PB1), SV1.7
SCL: IC7.P$25 ((SCL/INT0)PD0), R_U2.1, X2.5, X2.6
SDA: IC7.P$26 ((SDA/INT1)PD1), R_U1.1, X2.3, X2.4
SERVO1: IC7.P$29 ((IC1)PD4), JP_SERVO1.2
SERVO2: IC7.P$30 ((XCK1)PD5), JP_SERVO1.1
SERVO3: IC7.P$31 ((T1)PD6), JP_SERVO2.2
SERVO4: IC7.P$32 ((T2)PD7), JP_SERVO2.1
TX0: IC2.11 (T1IN), IC7.P$3 ((TXD/PDO)PE1)
TX1: IC7.P$28 ((TXD1/INT3)PD3), X1.2
V+: C_F13.1, C_FS.1, C_V4.1, IC8.OUT, JP_SERVO1.3, JP_SERVO1.4, JP_SERVO2.3, JP_SERVO2.4

Notes on the sheet:
Keplerboard
V. 7.0.2
Peter Weissig

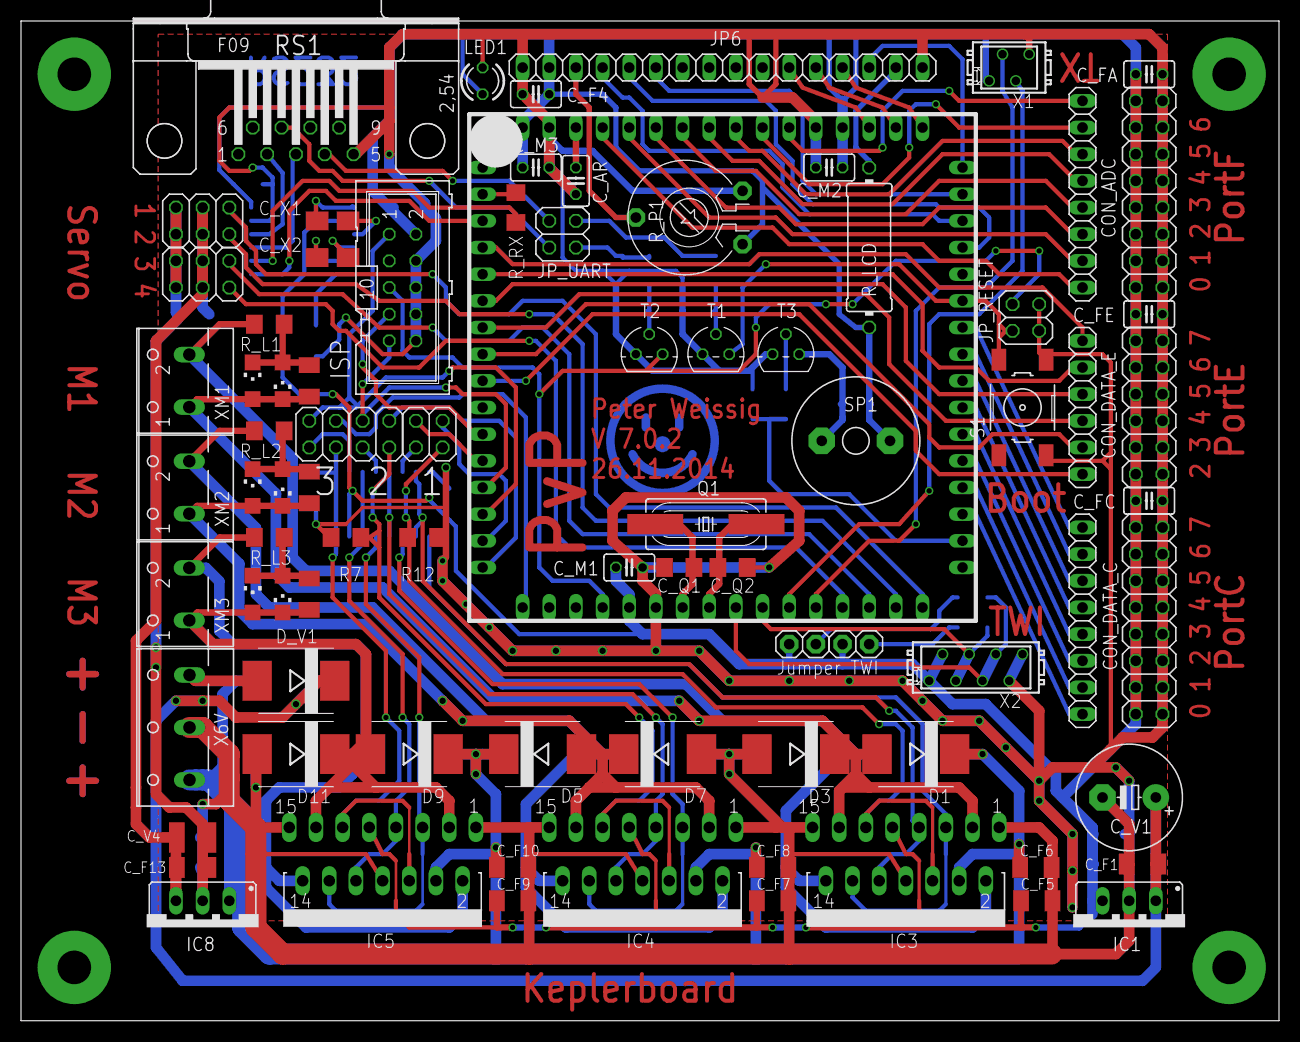
[picture p14: board circuit.brd from above]

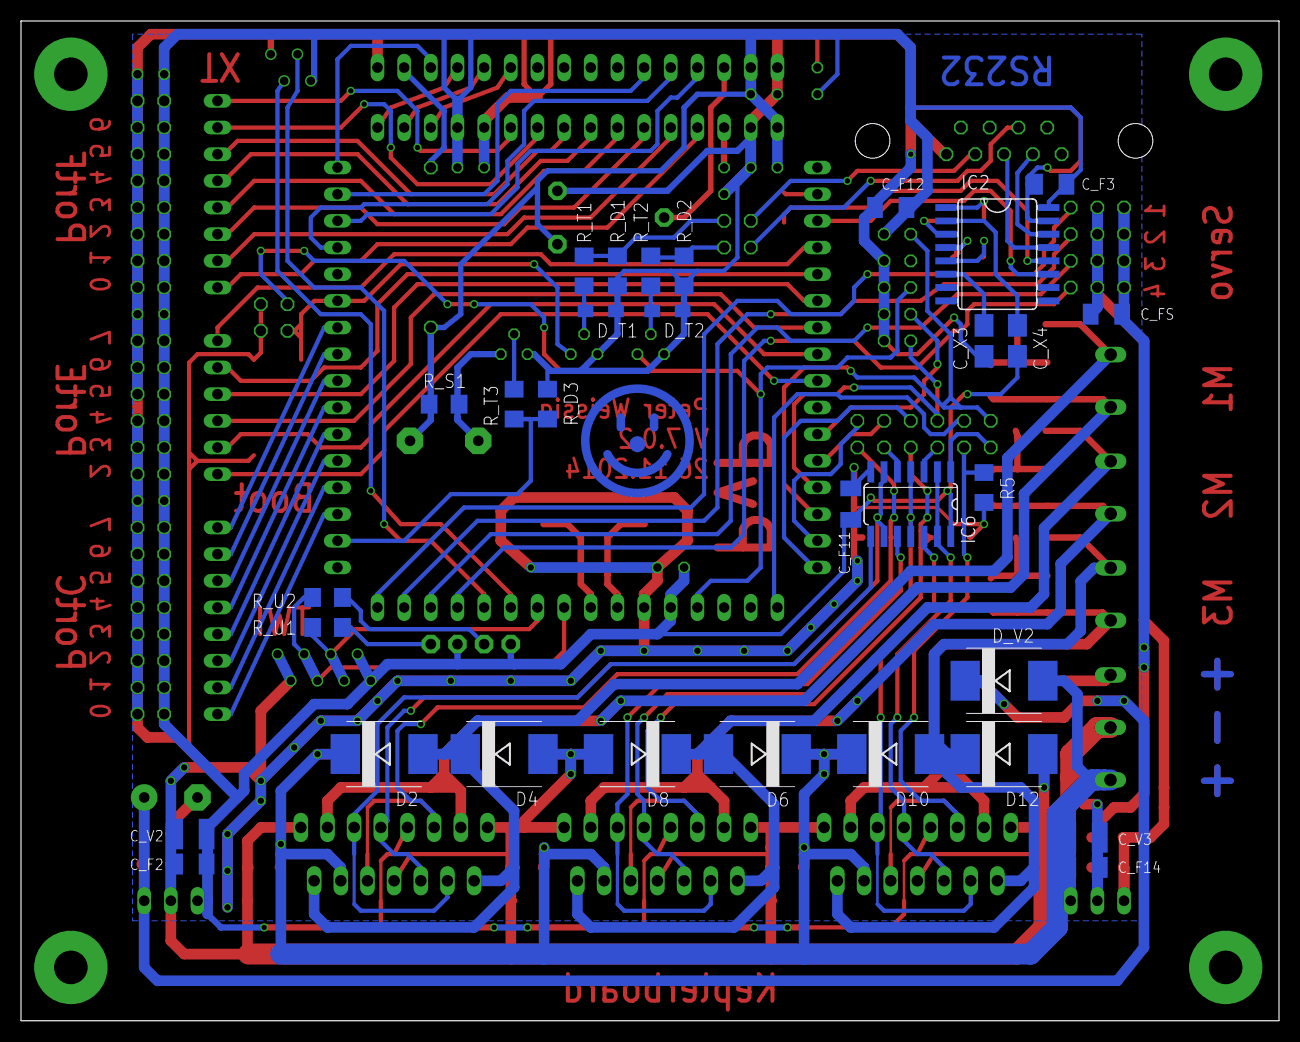
[picture p15: board circuit.brd from below]

Board: 2 copper layers, 119.8 x 95.2 mm, 114 parts (31 on the bottom side), 100 nets.
