RoboAG/eagle_keplerboard/(commit log)

2015-09-28 updated to version 2.0
    [circuit.brd, circuit.sch, mcu.brd]
2015-09-28 update to Version 3.0
    [circuit.brd, circuit.sch, mcu.brd]
2015-09-28 update to Version 4.1
    [circuit.brd, circuit.sch, mcu.brd]
2015-09-28 update to Version 5.8.4
    [circuit.brd, circuit.sch]
2015-09-28 update to Version 6.1.0
    [circuit.brd, circuit.sch]
2015-09-28 update to Version 7.0.1
    [circuit.brd, circuit.sch]
2015-09-28 update to Version 7.0.2
    [circuit.brd, circuit.sch]
2015-09-29 updated file "TODO" - error in schematics - ISP doesn't work
2017-11-26 updated LICENSE, TODO and added parts.ods
    [parts.ods]
